malavon/kicad-ch341-programmer/todo.txt

SUSUMU: -T1 = 100 stuks; goedkoper full reel??? TODO

KOPEN: clips!!!
