malavon/kicad-ch341-programmer/3dmodels/TBC05-02-1-G-G.stp

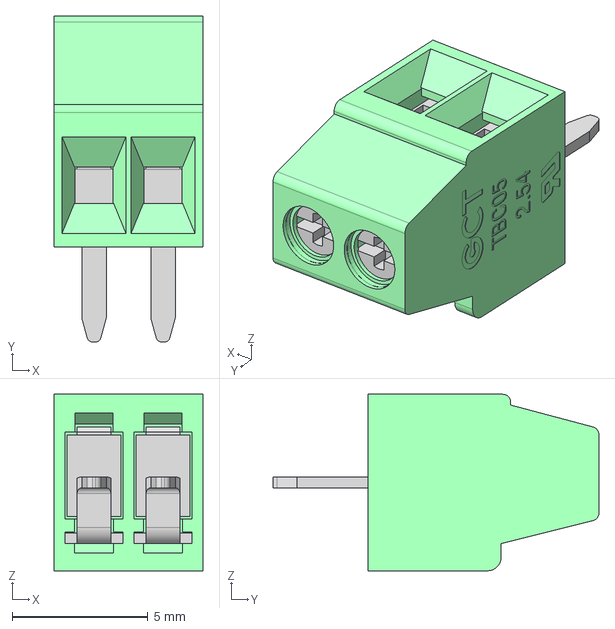
[picture p1: CAD file, 2026-05-10]
3dmodels/TBC05-02-1-G-G.stp
5.48 x 12.0 x 6.50 mm
TBC05-02-1-G-G_H
TBC05-02-1-G-G_P x 2
