malavon/kicad-ch341-programmer/3dmodels/amphenol_micro_usb_10118194-0011lf.step

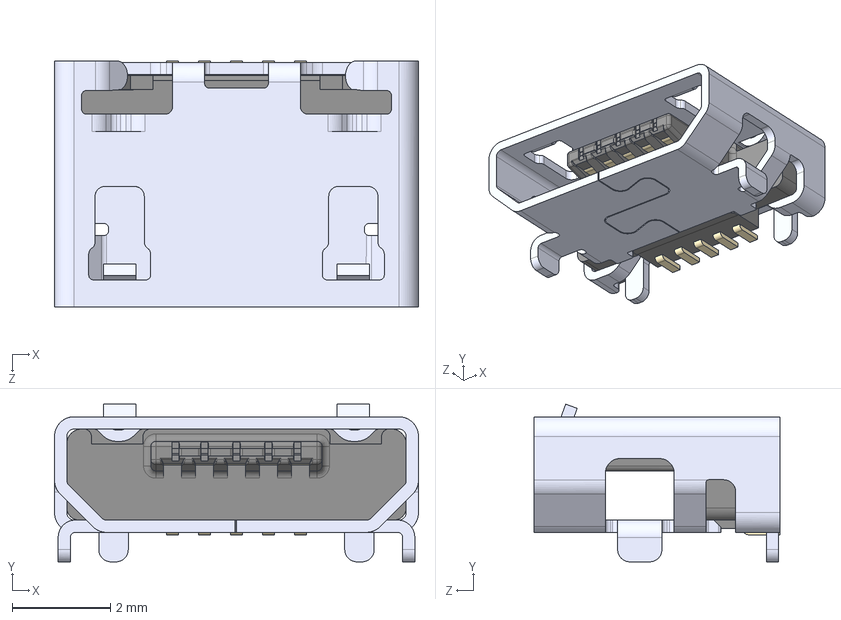
[picture p2: CAD file, 2026-05-10]
3dmodels/amphenol_micro_usb_10118194-0011lf.step
7.40 x 3.21 x 5.00 mm
