malavon/kicad-ch341-programmer/3dmodels/3m_zif_dip16_socket_216-3340-00-0602J_black.stp

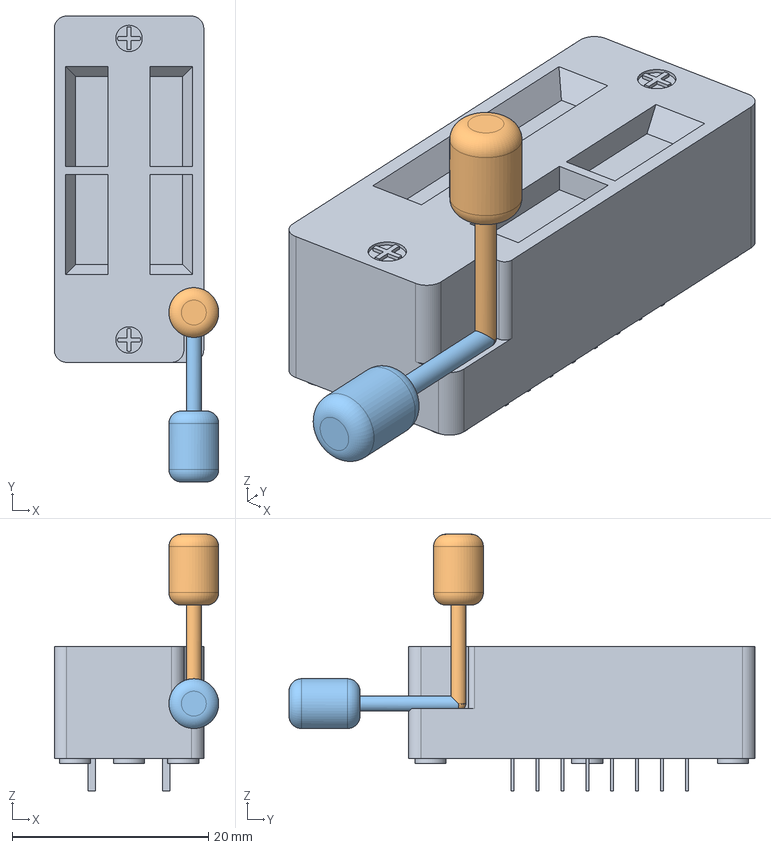
[picture p3: CAD file, 2026-05-10]
3dmodels/3m_zif_dip16_socket_216-3340-00-0602J_black.stp
16.8 x 47.5 x 26.2 mm
Compo-3
Compo-5
Compo-7
