malavon/kicad-ch341-programmer/3dmodels/c-282834-2-c-3d.stp

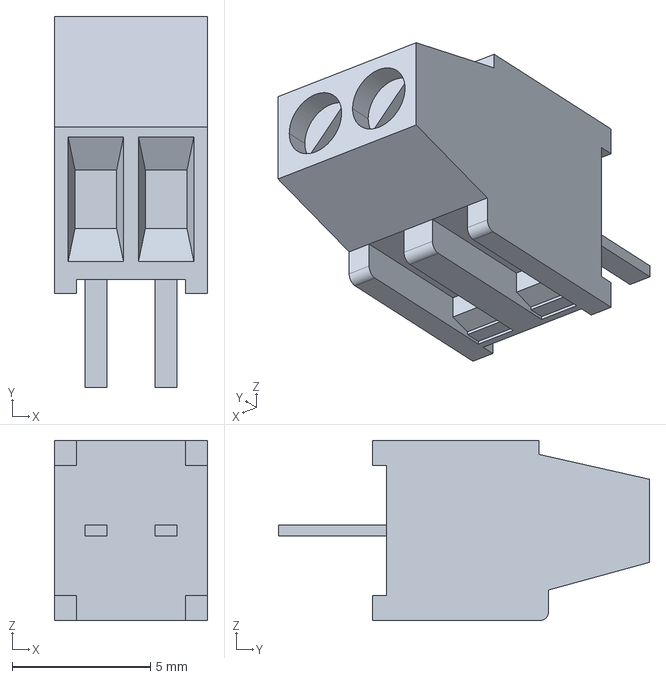
[picture p4: CAD file, 2026-05-10]
3dmodels/c-282834-2-c-3d.stp
5.54 x 13.4 x 6.50 mm
