malavon/kicad-ch341-programmer/3dmodels/397730002.stp

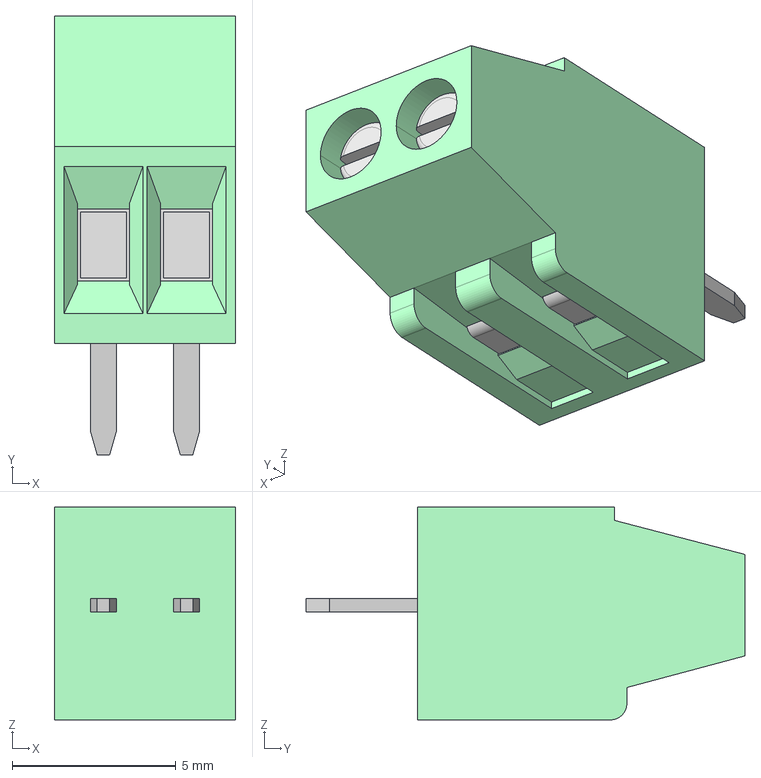
[picture p5: CAD file, 2026-05-10]
3dmodels/397730002.stp
5.54 x 13.4 x 6.50 mm
