malavon/kicad-ch341-programmer/(list of files, cad)

Other CAD files:
3dmodels/3m_zif_dip16_socket_216-3340-00-0602J_cyan.stp
3dmodels/3m_zif_dip16_socket_216-3340-00-0602J_parasolid.stp
