malavon/kicad-ch341-programmer/bios-programmer-ch341a.kicad_pcb

## KiCad design bios-programmer-ch341a.kicad_pcb (2026-05-10)

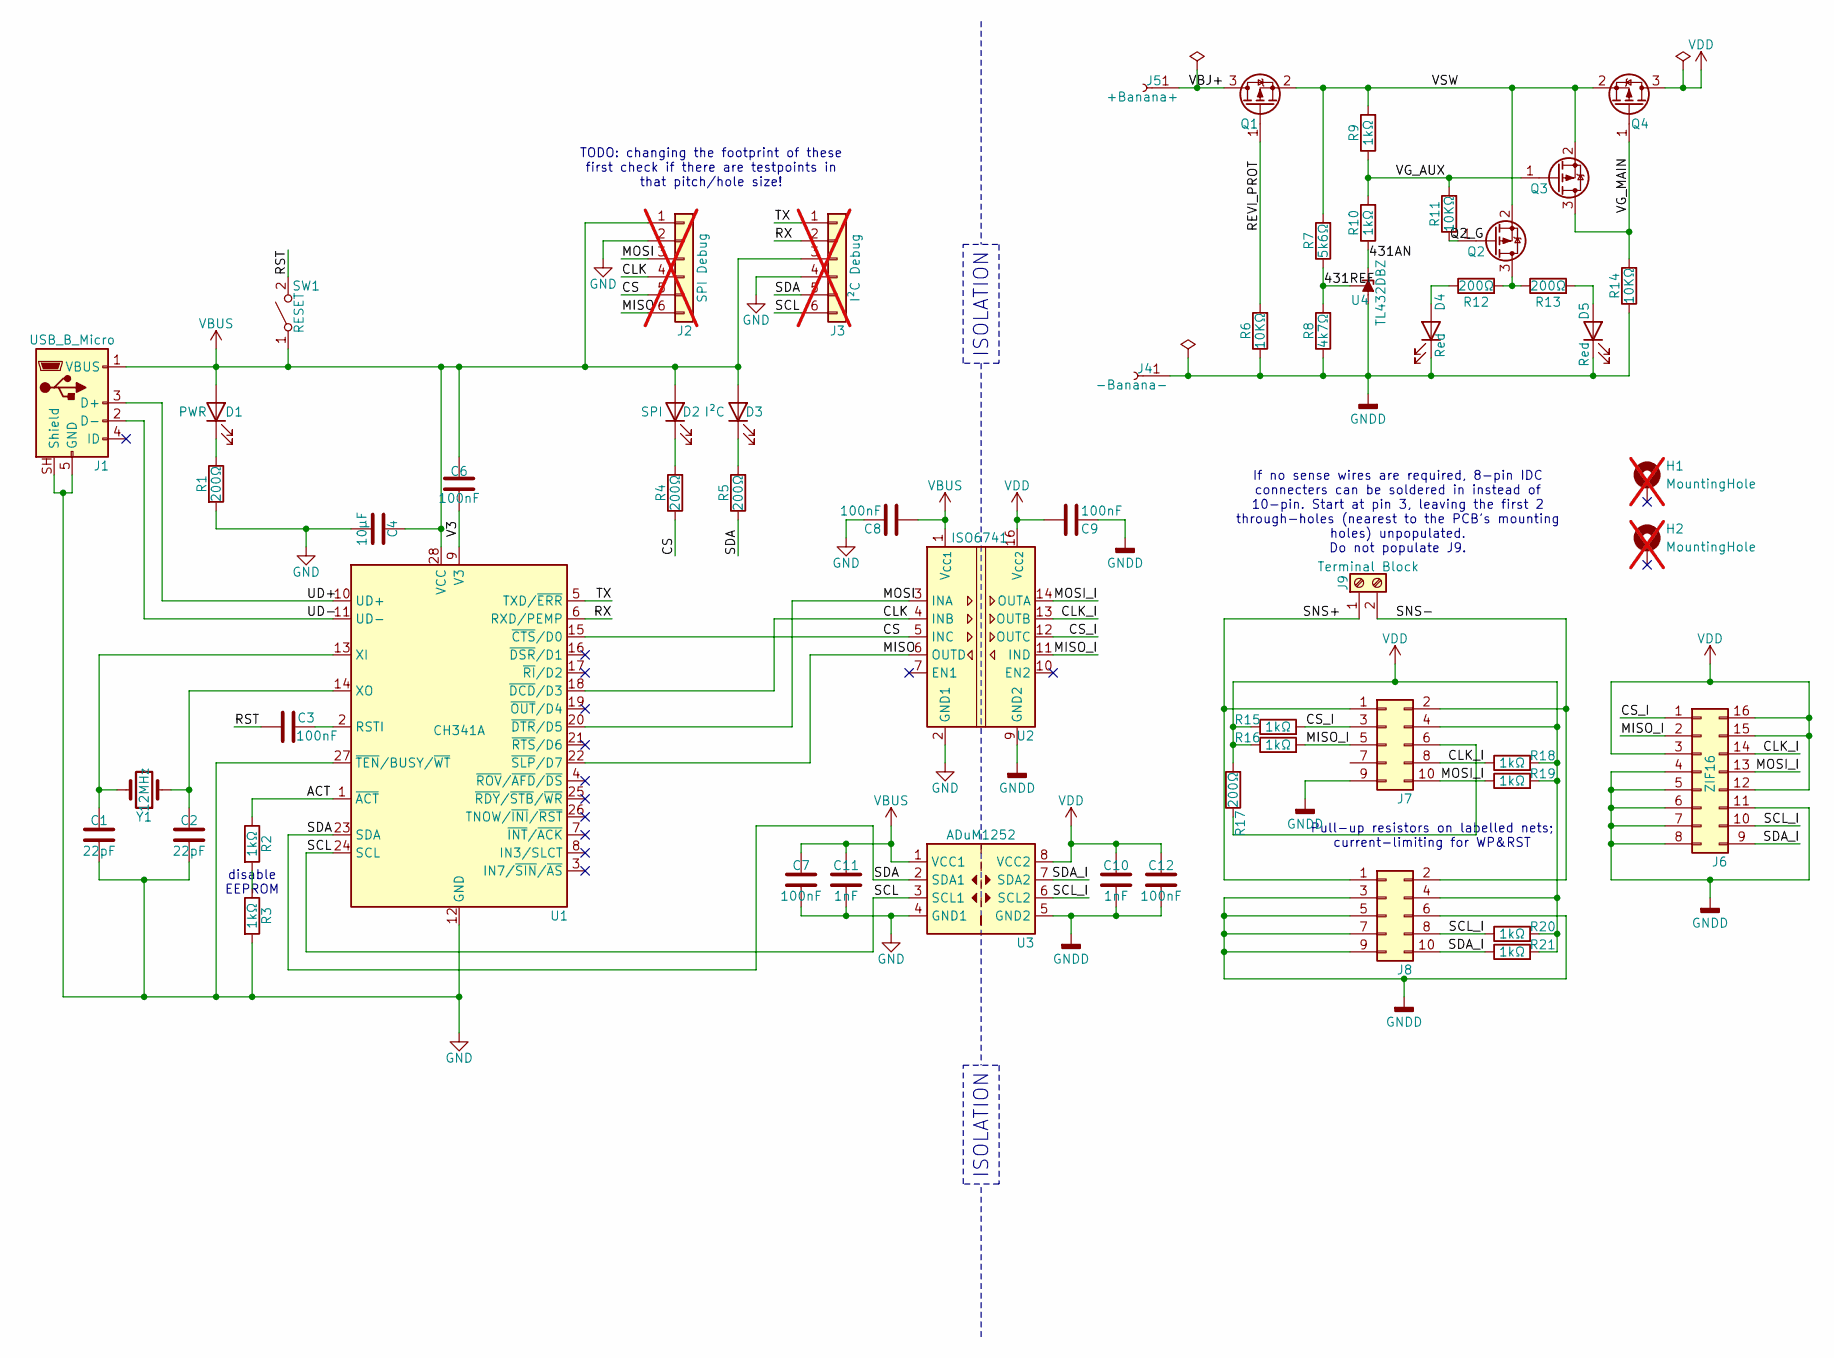
[picture p6: schematic bios-programmer-ch341a.kicad_sch]

Parts:
C1, C2: 22pF; C_0603_1608Metric_Pad1.08x0.95mm_HandSolder; Part KGM15ACG1H270GT
C3, C6, C7, C8, C9, C12: 100nF; C_0603_1608Metric_Pad1.08x0.95mm_HandSolder; Part CC0603KRX7R7BB104
C4: 10µF; C_0805_2012Metric; Part CL21A106KOQNNNF
C10, C11: 1nF; C_0603_1608Metric_Pad1.08x0.95mm_HandSolder; Part AC0603KRX7R0BB102
D1: Blue; LED_0603_1608Metric_Pad1.05x0.95mm_HandSolder; Part LTST-C194TBKT
D2, D3: YellowGreen; LED_0603_1608Metric_Pad1.05x0.95mm_HandSolder; Part HT-193UYG-5592
D4, D5: Red; LED_0805_2012Metric_Pad1.15x1.40mm_HandSolder; Part APT2012SURCK
H1, H2: MountingHole; MountingHole_2.2mm_M2_ISO14580_Pad_TopBottom; not fitted
J1: USB_B_Micro; USB_Micro-B_Amphenol_10118194-0001LF_Horizontal; Part 10118194(-0011LF)
J2: SPI Debug; PinSocket_1x06_P1.27mm_Vertical; not fitted
J3: I²C Debug; PinSocket_1x06_P1.27mm_Vertical; not fitted
J4: -Banana-; Banana_Cliff_FCR7350B_S16N-PC_Horizontal; Part FCR7350B
J5: +Banana+; Banana_Cliff_FCR7350R_S16N-PC_Horizontal; Part FCR7350R
J6: ZIF16; ZIF_Socket; Part 216-3340-00-0602J
J7, J8: IDC; IDC-Header_2x05_P2.54mm_Horizontal_1.64mm_pad; Part 61201021721
J9: Terminal Block; TerminalBlock_TE_282834-2_1x02_P2.54mm_Horizontal; Part TBC05-02-1-G-G
Q1, Q2, Q3, Q4: SSM3J328R; SOT-23; Part SSM3J328R
R1, R4, R5, R12, R13, R17: 200Ω; R_0603_1608Metric_Pad0.98x0.95mm_HandSolder; Part ERJ-3EKF2000V
R2, R3, R9, R10, R15, R16, R18, R19, R20, R21: 1kΩ; R_0603_1608Metric_Pad0.98x0.95mm_HandSolder; Part CQ03WAJ0102T5E
R6, R11, R14: 10KΩ; R_0603_1608Metric_Pad0.98x0.95mm_HandSolder; Part RC0603JR-0710KL
R7: 5k6Ω; R_0603_1608Metric_Pad0.98x0.95mm_HandSolder; Part RG1608P-562-D-T5
R8: 4k7Ω; R_0603_1608Metric_Pad0.98x0.95mm_HandSolder; Part RG1608P-472-D-T5
SW1: SPST; SW_Tactile_SPST_NO_Straight_CK_PTS636Sx25SMTRLFS; Part PTS636SKG25SMTR LFS
U1: CH341A; SOIC-28W_7.5x17.9mm_P1.27mm; Part CH341(A|B)
U2: ISO6741; SOIC-16W_7.5x10.3mm_P1.27mm; Part ISO6741DWR
U3: ADuM1252; SOIC-8_3.9x4.9mm_P1.27mm; Part ADUM1252ASA+
U4: TL432DBZ; SOT-23; Part TL432LIBCDBZ
Y1: 12MHz; Crystal_HC49-4H_Vertical; Part ABL-12.000MHZ-B2

Connections:
/431AN: R10.1, U4.2 (K)
/431REF: R7.1, R8.2, U4.1 (REF)
/ACT: R2.1, U1.1 (~ACT)
/CLK: J2.4, U1.18 (~DCD/D3), U2.4 (INB)
/CLK_I: J6.14, J7.8, R18.1, U2.13 (OUTB)
/CS: J2.5, R4.1, U1.15 (~CTS/D0), U2.5 (INC)
/CS_I: J6.1, J7.3, R15.2, U2.12 (OUTC)
/MISO: J2.6, U1.22 (~SLP/D7), U2.6 (OUTD)
/MISO_I: J6.2, J7.5, R16.2, U2.11 (IND)
/MOSI: J2.3, U1.20 (~DTR/D5), U2.3 (INA)
/MOSI_I: J6.13, J7.10, R19.1, U2.14 (OUTA)
/Q2_G: Q2.1 (G), R11.1
/REVI_PROT: Q1.1 (G), R6.2
/RST: C3.2, SW1.2 (B)
/RX: J3.2, U1.6 (RXD/PEMP)
/SCL: J3.6, U1.24 (SCL), U3.3 (SCL1)
/SCL_I: J6.10, J8.8, R20.1, U3.6 (SCL2)
/SDA: J3.5, R5.1, U1.23 (SDA), U3.2 (SDA1)
/SDA_I: J6.9, J8.10, R21.1, U3.7 (SDA2)
/SNS+: J7.1, J8.1, J9.1
/SNS-: J7.2, J8.2, J9.2
/TX: J3.1, U1.5 (TXD/~ERR)
/UD+: J1.3 (D+), U1.10 (UD+)
/UD-: J1.2 (D-), U1.11 (UD-)
/V3: C6.2, U1.9 (V3)
/VBJ+: J5.1 (Pin_1_1), Q1.3 (D)
/VG_AUX: Q3.1 (G), R9.1, R10.2, R11.2
/VG_MAIN: Q3.3 (D), Q4.1 (G), R14.2
/VSW: Q1.2 (S), Q2.2 (S), Q3.2 (S), Q4.2 (S), R7.2, R9.2
GND: C1.2, C2.2, C4.2, C7.2, C8.2, C11.2, J1.5 (GND), J1.SH (Shield), J2.2, J3.4, R1.2, R3.2, U1.12 (GND), U1.27 (~TEN/BUSY/~WT), U2.2 (GND1), U2.8 (GND1), U3.4 (GND1)
GNDD: C9.1, C10.2, C12.2, D4.1 (K), D5.1 (K), J4.1 (Pin_1_1), J6.4, J6.5, J6.6, J6.7, J6.8, J6.11, J7.9, J8.3, J8.5, J8.6, J8.7, J8.9, R6.1, R8.1, R14.1, U2.9 (GND2), U2.15 (GND2), U3.5 (GND2), U4.3 (A)
unnamed: D1.1 (K), R1.1
unnamed: D2.1 (K), R4.2
unnamed: D3.1 (K), R5.2
unnamed: D4.2 (A), R12.1
unnamed: D5.2 (A), R13.2
unnamed: Q2.3 (D), R12.2, R13.1
unnamed: R2.2, R3.1
unnamed: C3.1, U1.2 (RSTI)
unnamed: C1.1, U1.13 (XI), Y1.2
unnamed: C2.1, U1.14 (XO), Y1.1
VBUS: C4.1, C6.1, C7.1, C8.1, C11.1, D1.2 (A), D2.2 (A), D3.2 (A), J1.1 (VBUS), J2.1, J3.3, SW1.1 (A), U1.28 (VCC), U2.1 (V_{CC1}), U3.1 (VCC1)
VDD: C9.2, C10.1, C12.1, J6.3, J6.12, J6.15, J6.16, J7.4, J8.4, Q4.3 (D), R15.1, R16.1, R17.2, R18.2, R19.2, R20.2, R21.2, U2.16 (V_{CC2}), U3.8 (VCC2)

Notes on the sheet:
disable EEPROM
TODO: changing the footprint of these first check if there are testpoints in that pitch/hole size!
If no sense wires are required, 8-pin IDC connecters can be soldered in instead of 10-pin. Start at pin 3, leaving the first 2 through-holes (nearest to the PCB's mounting holes) unpopulated. Do not populate J9.
ISOLATION
Pull-up resistors on labelled nets; current-limiting for WP&RST

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
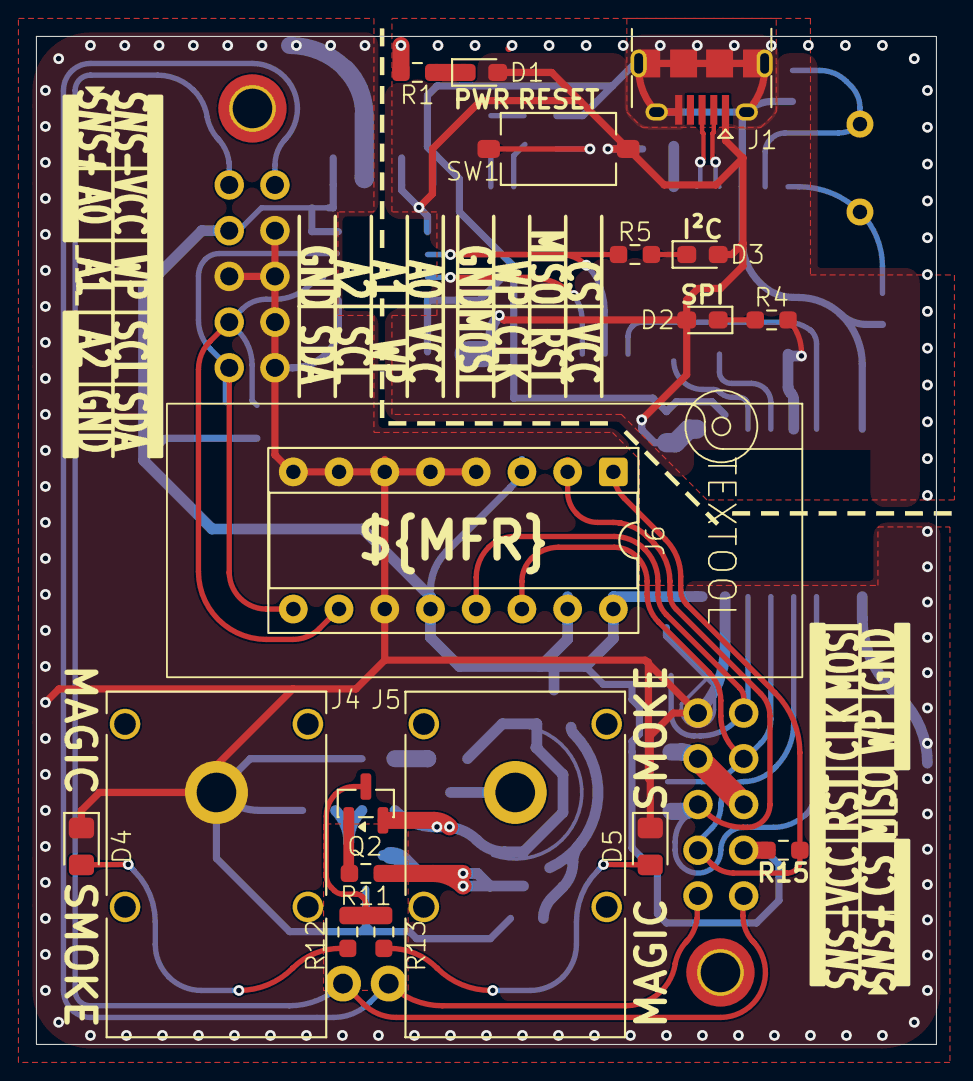
[picture p7: board bios-programmer-ch341a.kicad_pcb from above]

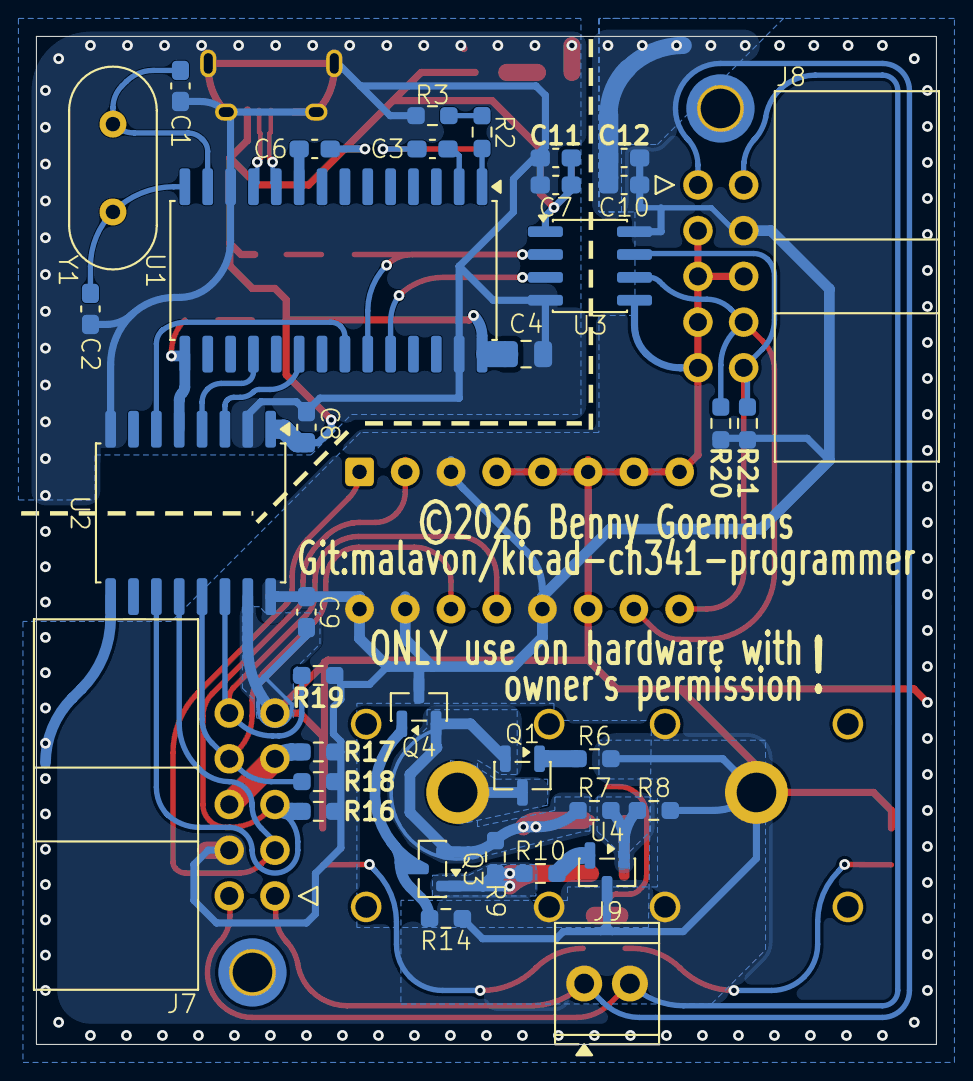
[picture p8: board bios-programmer-ch341a.kicad_pcb from below]

Board: 2 copper layers, 50.0 x 56.0 mm, 56 parts (36 on the bottom side), 42 nets.
