malavon/kicad-ch341-programmer/(commit log)

2026-05-05 SCH: off-the-shelf CH341a programmer
    Typical CH341a programmer, based on a schematic I found on or via EEVBlog.
    It groups all capacitors at the moment, but that's fine. Capacitances will need
    to change anyway. I didn't use a resistor network like the programmer does, but
    nothing stops me from changing this later on.
    [bios-programmer-ch341a.kicad_pcb, bios-programmer-ch341a.kicad_sch]
2026-05-05 SCH: initial isolated version
    It's more than likely that the isolation pinout will change for easier routing.
    All DRC rules are passed EXCEPT one: SCL connection complains that it's not
    connected to power on the ZIF socket. Either this is a DRC mishap, or something
    is actually wrong with the idea or the isolator used.
    Note: isolator part numbers are expected to change, hopefully pinout doesn't.
    It's possibly I decide to use a 4 or 6-channel isolator instead of 3 dual ones.
    [bios-programmer-ch341a.kicad_sch]
2026-05-05 Temporary footprint assignations.
    Missing:
    * ZIF socket
    * correct 3.3V regulator (schematics)
    * BANANA JACKS!!
    * correct USB plug; vertical? horizontal? sideways like laptop...
    * no inductor??? (original schems)
    [bios-programmer-ch341a.kicad_pcb, bios-programmer-ch341a.kicad_sch]
2026-05-05 Correct isolator types
    Initially I was hoping to re-use isolation for both the I2C & SPI memory types.
    In short, I require 1.8V operation on at least one side. This is already hard
    to find in I2C regulators (e.g. TI does only 2.25V parts).
    However, the I2C parts are considerably more expensive, so reusing those would
    more than double the price (in total). On top of that, they only support speeds
    up to 2MHz.
    On the SPI side there are a few options, most notably TI's ISO65xxx range. It's
    the cheapest option, but only comes in a smaller package than I'd really like
    for handsoldering. Therefore I went with the slightly older ISO67xxx option.
    This is the same package width/pitch as the CH341a it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
    [bios-programmer-ch341a.kicad_pcb, bios-programmer-ch341a.kicad_sch]
2026-05-05 Added the 3M TEXTOOL 16-pin ZIF socket footprint & 3D model
    Note: the CH341a programmers usually use a TFXTDOL (sic...) ZIF socket.
    Surely it won't be the same quality but I guess it gets the job done for a
    fraction of the price (a programmer is sold at 0.80 Euro, the ZIF socket is
    sold for 22...).
    The 3D model for the ZIF socket makes it clear how big it is. This is also
    evident on other programmers using one of these, but it's good to have it to
    check for clearances.
    [bios-programmer-ch341a.kicad_pcb, bios-programmer-ch341a.kicad_sch]
2026-05-05 Banana Jack footprints
    At first I couldn't find any banana jack footprints, but I guess they're there
    nonetheless. The one I chose has the same footprint but is from a different
    manufacturer, Schuetzinger.
    And now I don't need to provide the 3d model either. Win!
    [bios-programmer-ch341a.kicad_pcb, bios-programmer-ch341a.kicad_sch]
2026-05-05 Changed USB A to Micro USB
    First question: why not USB-C? Simple, because I have many more Micro USB
    cables lying about. Also, I have a few issues with how USB-C was both designed
    and came to fruition. That said, it should be trivial to redesign a USB-C port
    on the PCB (and I may do this in the future).
    [bios-programmer-ch341a.kicad_pcb, bios-programmer-ch341a.kicad_sch]
2026-05-05 3D: model for Amphenol Micro USB, PN 10118193-0002LF (2=without flange)
    Apparently this model requires a very big lateral movement, but I guess it'll
    be fine.
    [amphenol_micro_usb_11018193_2lf.stp, bios-programmer-ch341a.kicad_pcb]
2026-05-05 Notes after reading the CH341 datasheet & crystal package
    The todo list has been expanded with both additions and simplifications. I'll
    be running the CH341 on 5V since it never connects directly to any chip.
    It would also be perfectly fine to provide less capacitance if there's no real
    load on the device, especially no chance of a surge current on the USB bus.
    All programming load will be monitored by the external connection anyway.
    [bios-programmer-ch341a.kicad_pcb, bios-programmer-ch341a.kicad_sch]
2026-05-05 Removed voltage regulator, running from VBUS directly + dual status LEDs
    I left the debug headers intact for now but that's next up.
    Having dual LEDs as status LED is rather useful, I could have these next to the
    ZIF socket to notify the user which one is getting used. It might prevent some
    user errors.
    Note: future (alternatives) will probably not use a ZIF socket but connect to a
    clip through a ribbon wire. OR I may decide to put it all on a single PCB.
    [bios-programmer-ch341a.kicad_pcb, bios-programmer-ch341a.kicad_sch]
2026-05-05 Cleanup of tracks and condensing a bit + adding the Ohm symbols again
    I cannot resist using correct units.
    The layout as it is doesn't cross any signals, at the cost of becoming slightly
    more difficult to follow. Then again, it's a simple design and supposed to stay
    that way.
    [bios-programmer-ch341a.kicad_pcb, bios-programmer-ch341a.kicad_sch]
2026-05-05 Added a reset switch and removed RST & ACT signals from debug headers
    The reset is probably useful, I've had plenty of times that one of these CH341
    chips or the chip under programming stopped responding because something went
    wrong with the software.
    No need to unplug the USB all the time, reset switches should be more omni-
    present.
    Those 2 extra signals aren't really needed for debugging if there's a switch,
    ACT was barely useful anyway. Also note that these parts are DNP anyway.
    And I might turn it into 2mm or even 1mm pitches if need be. I should check up
    on test point (those clip-on ones) sizes before I do so though.
    [bios-programmer-ch341a.kicad_pcb, bios-programmer-ch341a.kicad_sch]
2026-05-05 Isolators input (VCC) capacitance
    Added the required input capacitance on both isolators as specified in the
    datasheet.
    [bios-programmer-ch341a.kicad_pcb, bios-programmer-ch341a.kicad_sch]
2026-05-05 PCB: IDC connector on the bottom, also functioning as standoffs
    The idea is that a chip can be programmed through the ZIF socket or by connect-
    ing a cable with a in-place programming clip.
    This may however lead to issues and in hindsight it might become a questionable
    decision: the high-speed signals will be branched and lead nowhere, which may
    lead to reflections and thus signal integrity failure.
    The cheap CH341 programmers do not use separate IDC connectors but instead
    use the ZIF socket and a IDC adapter. This does prevent possible signal
    integrity issues at the cost of an ugly adapter which doesn't prevent mis-
    alignment.
    If I choose to go this route myself I will have to create a be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
    [bios-programmer-ch341a.kicad_pcb, bios-programmer-ch341a.kicad_sch]
2026-05-05 First layout test & opt for 2 IPC connectors instead of 4
    This layout is very preliminary and I'm committing this because I want to try
    out a different layout.
    Using 2 IPC connectors is probably best:
    * still provides support when used diagonally - at least I expect them to
    * no branching of signals, just one long string crossing THROUGH the ZIF socket
    Note that I'm having some troubles with the USB connection, D+ & D- are in the
    wrong way to link directly to the CH341a when used on the same side.
    So either I need to find a Micro USB B with through hole signal connections,
    or I need to cross them by using an extra pair of vias.
    [bios-programmer-ch341a.kicad_pcb, bios-programmer-ch341a.kicad_sch]
2026-05-10 PCB: redesign, reducing footprint & optimizing layout
    IMPORTANT: I've switched up the footprint of the ZIF socket (will require
    doublechecking) in order to improve the routing.
    All in all I'm pretty content with this layout idea, routing goes well and most
    of the important parts have been routed in this example.
    However, due to the orientation of the CH341 it will be difficult to route the
    USB data signals. Since these are high-speed - the highest of all signals on
    this board - it is imperative that these are routed better. On top of that it's
    good to route these within a grounded channel.
    Then the test headers...they have been giving me trouble. In fact that's the
    reason I rotated the CH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
    [bios-programmer-ch341a.kicad_pcb, bios-programmer-ch341a.kicad_sch]
2026-05-10 PCB: reset button & ACT pulldown
    Pulling down ACT (throught a resistor) disables the CH341 EEPROM check to find
    its configuration. Only programmatic configuration is supported in order to
    switch from SPI to I2C and vice versa.
    PROBLEM: while checking the PCB I noticed that the ZIF socket - for which I've
    changed the signal order - isn't correct. Or technically it is, it's just
    upside down. However, it would be nicer to have pin 1 of the zif socket be
    pin 1 of the (first of two) memory chips.
    Changing this will change a lot of the signals coming from the isolators and
    going towards the IDC connectors.
    [bios-programmer-ch341a.kicad_pcb, bios-programmer-ch341a.kicad_sch]
2026-05-10 PCB: Fixed the ZIF socket layout, pin 1 is pin 1 on SPI (NOT EEPROM)
    I still keep the 25/24 order simply because the layout gets much worse if I
    change these up. There will be a very clear silkscreen explaining which chip
    goes in which part of the socket (including the pinout).
    PROBLEM: I did notice that one the left side of the PCB there's GND and GNDD
    overlapping each other. Unless I can fix this easily another way, I can only
    see one possible fix: place U3 (I2C isolator) in-between the J8 (IDC connector)
    and U1 (the CH341 IC).
    Most likely this will mean there is no more room to place the debug headers,
    permanently or temporarily.
    [bios-programmer-ch341a.kicad_pcb, bios-programmer-ch341a.kicad_sch]
2026-05-10 PCB: Isolation of I2C signals without overlapping ground connections
    As expected this solution seems to make it impossible to have the debug headers.
    Unless I can find a way they won't be there in the final version.
    [bios-programmer-ch341a.kicad_pcb, bios-programmer-ch341a.kicad_sch]
2026-05-10 Footprint: Micro USB (Amphenol 10118194) footprint & 3d model
    Right part number: 10118194-0011LF
    4 DIP part, best structual support I could find. 11 stands for "without flange"
    and "76um au"
2026-05-10 PCB: updated Micro USB B model to Amphenol 10118194-0011LF + IC capacitance
    [bios-programmer-ch341a.kicad_pcb, bios-programmer-ch341a.kicad_sch]
2026-05-10 Idea on a possible overvoltage protection circuit that might work - or not
    Copy from the schematics:
    * zener diode 5.6V
    * switches off a P-mosfet on the banana rail
    * but what about a LED
    * cannot just put a LED in series, right?
    * calculate!! Vfz=0.9V, Vfled=2.0V
    * it's fine, isn't it??
    combined forward voltage well below the 5.6V
    * can the MOSFET still switch when 3.6V is applied?
    * gate voltage needs to be higher than what is switched?
    [bios-programmer-ch341a.kicad_sch]
2026-05-10 PCB: placing capacitors, crystal & LEDs + reference designators placed
    LEDs are on top since that's obviously where the user will see them. Still no
    debug headers present, I don't think I'll be putting them in.
    The crystal is changed into the same crystal that I can find on the CH341
    programmer PCB. I'm not sure they're easy to recover and safe to reuse.
    Nonetheless I'm consdering buying CH341 programmers and recovering the chips &
    ZIF sockets. The cost difference is quite big (especially for the sockets).
    Tracks certainly still need to be cleaned up, zones laid out etc. Still some
    rework as well, but it's good enough to have an idea and maybe post it out on
    an electronics forum. Let's hop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
    [bios-programmer-ch341a.kicad_pcb, bios-programmer-ch341a.kicad_sch]
2026-05-10 PCB: intermediate commit with fixes & changing solder mask color for each layer
    First things first, of course I have no intention of ordering this PCB ever
    with two different solder mask colors. It's simply to make it easier for me to
    see what's happening. Since I use the 3D viewer a lot to inspect zones in a
    much cleaner perspective than in the PCB editor, having two different colors
    makes it easier to distinguish them both. Especially without models populated
    they look not that much different from each other, I've had a few moments I had
    to doublecheck which side I'm one.
    Some tracks have been rerouted to allow for bigger zones where possible.
    Isolated GND is on top, isolated voltage on t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
    [bios-programmer-ch341a.kicad_pcb]
2026-05-10 PCB: isolated GND on top and isolated power at the bottom
    The other way around results in messier routing and the PCB is big enough to
    have a few tracks around to provide power, which are then usurped into zones.
    Note that I have a habit - for the 4 pcb's I've more or less designed - of
    connecting all pins before going into zones. Zones might be a useful tool to
    see if routing is possible, but I prefer it this way because it makes me think
    more about the layout and its consequences.
    VBUS & GND are not yet done, at this stage I'm still trying to figure out which
    net to put on which side of the board.
    [bios-programmer-ch341a.kicad_pcb]
2026-05-10 PCB: routed VBUS at the bottom, GND on top
    I tried it the other way around with VBUS on top and GND on the bottom side,
    but this resulted in pretty annoying jumps & vias. This one is cleaner, there's
    only one overjump to be made.
    [bios-programmer-ch341a.kicad_pcb, bios-programmer-ch341a.kicad_sch]
2026-05-10 PCB: moved ISO6741 more inwards
    Originally pins for the socket came out much further since it was oriented
    differently and - I think - I kept it this far to the side just by coincidence.
    [bios-programmer-ch341a.kicad_pcb, bios-programmer-ch341a.kicad_sch]
2026-05-10 PCB: ring of fire; grounded vias around the pcb to improve signal integrity.
    This is something I saw on the black version of the CH341 programmer and I
    wanted to try out laying this out as well.
    The green versions that I have - which have a voltage selection switch - do not
    have such a ring and they work perfectly fine (with the limitations of these
    simple devices). Not sure if it's useful at all thus, but I'm going to assume
    that it doesn't harm anything. Let's hope these aren't going to be famous last
    words.
    Having added this it's clear that there is quite a bit of extra surface area
    that hasn't been used nor has any use. So if I decide to remove this ring at a
    later stage, I might just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
    [bios-programmer-ch341a.kicad_pcb, bios-programmer-ch341a.kicad_sch]
2026-05-10 PCB: components moved inside Ring of Fire + fixed grouping & locking
    While I will never know if this ring around the PCB has any merit, it does mean
    that some of the components had to move a bit. No issues created as far as I
    can see.
    The grouping that I had done was apparently messed up, so I've had to redo this
    by moving them to the side and finally grouping, moving back & locking them.
    Note sure if it was messed up because of a bug or by design - or something I
    did wrong.
    [bios-programmer-ch341a.kicad_pcb, bios-programmer-ch341a.kicad_sch]
2026-05-10 PCB/footprints: Replaced reset switch with a smaller (and cheaper) model
    C&K PTS636 is also already in Kicad, it's affordable and should be more than
    enough for this simple board.
    More notably it's rectangular and takes up less space than the big one I had
    before. I do like that one better, but it's a bit big for this board.
    Now it'll also be possible to have it all on the - unofficially - isolated side
    of the pcb.
    [bios-programmer-ch341a.kicad_pcb, bios-programmer-ch341a.kicad_sch]
2026-05-10 PCB: so satisfying ... rounded some tracks just because I can :)
    Yeah, I shouldn't ben doing this since it's strictly not necessary. But just
    imagine all these electronics moving at light speed and then bumping again a
    sharp corner! They might hurt themselves, possibly leading to a universe-ending
    event. Or not.
    Technically I'm pretty sure I read a application note or something about it
    once, but I'm also pretty sure that all of this has happened before at least
    once. So yeah, fun life, right?
    [bios-programmer-ch341a.kicad_pcb]
2026-05-10 PCB: added silkscreens for pin layout and found BIG ISSUE
    These silkscreens are quite important simply to understand what the device does
    and prevent mistakes. They need to be correct and placed in a way they can be
    read easily without mistakes.
    As I expected I seem to have made a mistake on at least the pinouts of the IDC
    connectors. That's too bad since I'l have to reroute them after correcting this.
    First things first however, I'm going to verify the pinout of both the IDC con-
    nectors and the ZIF socket with every reference I have.
    The worst thing that could happen - as it's hard to fix with an extra compoent
    or a hookup wire - is a mistake in the pinouts. All of the PCBs that I order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
    [bios-programmer-ch341a.kicad_pcb, bios-programmer-ch341a.kicad_sch]
2026-05-10 SCH/PCB: corrected external pinouts - hopefully correct now
    First part that was wrong was the footprint vs symbol which didn't have a
    compatible pin numbering. Then aside from that there were still mistakes that
    lead to wrong pinouts.
    By rerouting the SPI signals it seems easiest to route them under the ZIF
    socket, which I've been able to prevent previous time. Not that that's much of
    an issue as far as I can estimate.
    The silkscreen legend for the ZIF socket was also wrong, somehow I still have
    the layout from the off-the-shelf programmers (with 24xx on top) in my mind.
    This is definitely one of the downsides of changing this, but also show the
    importance of having good silkscreen legends.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
    [bios-programmer-ch341a.kicad_pcb, bios-programmer-ch341a.kicad_sch]
2026-05-10 SCH: overvoltage (concept)
    [bios-programmer-ch341a.kicad_sch]
2026-05-10 PCB: cleaned up DRC errors & moved silkscreens/vias neater
    Not that it matters much because while doing this I noticed it might be better
    to move a few IC's, including the CH341. This will mean all tracks are moved as
    well, breaking a lot of things.
    Definitely one of the things Kicad doesn't exactly excel at.
    prolly temp: cleaned up DRC errors, moved silkscreens/vias where need be
    but going to move a few IC's ... breaking all tracks and creating more errors
    [bios-programmer-ch341a.kicad_pcb]
2026-05-10 PCB: moved U1 (CH341) closer to J8/U3 (I2C isolator) and more beautification
    Moving U1 is useful to make extra room for the crystal - even if I decide to
    choose a different footprint. It's one of the most sensitive components.
    Of course moving this meant that all tracks and thus vias on the USB/host-side
    also needed moving. I decided to use this opportunity to give components some
    extra room where possible. While I'm certain I can handsolder this, simply for
    interference reasons it might be worth it.
    I also moved all vias that clipped silkscreen now. I had done this before but
    of course changes to the slikscreen and its placement meant the vias would clip
    it. Anywhere it's relevant - visib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
    [bios-programmer-ch341a.kicad_pcb, bios-programmer-ch341a.kicad_sch]
2026-05-10 3D: model of the ZIF socket
    This model is embedded in the footprint that I made, which I prefer. But it's
    good to keep the model in the repo as well, just to be complete.
    Note that this was originally a parasolid .x_t file, which I managed to convert
    using an online converter. Apparently no open-source solutions exist?
    [3m_zif_dip16_socket_216-3340-00-0602J_parasolid.stp]
2026-05-10 Kicad jobsets to generate outputs/exports; no real success though
    It seems that not everything that is possible with the CLI is also possible
    from the jobsets. On top of that I also wasn't able to zip the gerbers using a
    separate command. Note that documentation I saw would mention an 'archive' task
    but I haven't found this one.
    [bios-programmer-ch341a.kicad_pcb, bios-programmer-ch341a.kicad_sch]
2026-05-10 EXPORT: exporting using script & kicad-cli
    The CLI has more options than the jobsets do, or at least the jobsets' UI has.
    It's not the most efficient option since it has to re-read the project each for
    each export.
2026-05-10 PCB: moved to the exact center of the page for cleaner export results
    It's more or less unnecessary, but it does make it easier to print out the PCB
    doublesided (assuming it's correctly rotated or mirrored).
    [bios-programmer-ch341a.kicad_pcb]
2026-05-10 SCH: Initial version of overvoltage protection
    While trying to get a grasp of this design which was proposed by ChatGPT very
    confidently I started to delve into simulating.
    I decided to keep this commit but DO KNOW that this circuit doesn't work. It's
    just here to remind me to simulate before even putting things into a schematic.
    And of course not trust LLMs to generate something even reasonably close, just
    like I have witnessed these things do with code.
    [bios-programmer-ch341a.kicad_sch]
2026-05-10 SIM: QUCS-S simulations for overcurrent protection
    I've included several versions of an overvoltage protection circuit I found on
    Stack Exchange. I arrived there after trying to have ChatGPT create a circuit
    or at least help me in doing so. It was very good at being confidently useless,
    especially when I started simulating its creations. It's also rather funny to
    see it confuse P- and N-channel symbols and other stuff.
    That said, it's not completely useless, but there needs to be a good way to
    verify options before believing its output. This is by far my experience with
    trying to have it generate working code. It's very good at bullshitting when
    something doesn't work and going on an endles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
    [basedonstackex.sch, stackexchange1.sch, stackexchange2.sch]
2026-05-10 SIM: models for a few zener diodes and P-channel MOSFETs
2026-05-10 SIM: changing components to to library ones, output voltage goes above 6V
    Using library components ensures that there are no mistakes in the models.
    In this case ChatGPT was actually useful in noticing errors, although QUCS-S
    does seem to use 'M' for 'milli' instead of 'mega' as it should? Odd.
    Using these models the output voltage is allowed to go over 6V, which is rather
    high. This could be alleviated using a 5.1V Zener diode presumably.
    [basedonstackex.sch, stackexchange2.sch]
2026-05-10 SIM: simulation using a TI TL431 shunt diode
    ChatGPT mentioned this as a better solution to the Zener design, most likely
    helped by ingesting sites like Stack Exchange & reddit...
    Anyway, on the previously mentioned SE thread there's also a TL431 option, so
    I decided to try that one instead of going through trial and (a lot of) error
    using LLMs.
    [basedonstackextl341.sch]
2026-05-10 SIM: added diode to remove undershoot when sweeping load resistance
    Recommended by ChatGPT of course, not on the SE design. In fact, the SE design
    has a resistor feeding back into the TL431's reference. I tried this too, but
    the design didn't get cleaner at all. It actually got worse so it's starting to
    feel like a tuning problem, something I'd rather not have. I prefer a circuit
    that isn't too unstable, depending on other components.
    [basedonstackextl341.sch]
2026-05-10 SIM: added temperature option to simulate temperature effects
    I'm sure I can sweep this somehow, I think I saw it in the QUCS-S tutorial pdf.
    [basedonstackextl341.sch]
2026-05-10 SIM: includes LED indicated & removed capacitor
    The simulation seems to be quite good, although there are still some issues at
    low loads. The output voltage seems too low in those cases, which shouldn't
    really happen.
    [basedonstackextl341.sch]
2026-05-10 SCH: moving the simulated power protection circuit into Kicad
    [bios-programmer-ch341a.kicad_sch]
2026-05-10 SCH: added mounting holes & footprints assigned for PCB
    Mounting holes aren't strictly necessary and could in fact create some sort of
    coupled effects into the (isolated) ground plane. Especially when putting this
    in a metal case and connecting the USB ground to the case (hard to avoid) I
    don't know what the effects would be. That said, mounting holes are useful.
    [bios-programmer-ch341a.kicad_sch]
2026-05-10 PCB: power protection path laying out components
    [bios-programmer-ch341a.kicad_pcb]
2026-05-10 SIM: using Zener diode & schottky on output
    The Zener diode is used in the stack exchange post as a simple solution to
    create a voltage cut-off. The Schottky diode on the output is a stop-gap
    measure proposed by ChatGPT to reduce some ringing. I do not like this solution
    much though.
    [basedonstackex.sch]
2026-05-10 SIM: TL431 resistor changes & led current increase
    Brighter (error) LEDs are fine, but at higher voltages this will overdrive them
    and thus destroy them. It shouldn't really happen though, the operating point
    for this design is between 1.8 and 5V. Overvoltage should be 5.5-6V, not 8V or
    much higher.
    [basedonstackextl341.sch]
2026-05-10 SCH: updated protection circuit in line with simulation changes
    Replaced the 5.6K resistor with a second 4.7K combined with a 1K one. It saves
    one type of resistor to be ordered.
    220 ohm resistor on LED.
    [bios-programmer-ch341a.kicad_sch]
2026-05-10 PCB: swapped banana pos & neg! Using TL432 alternate for overvoltage circuit
    Ok, first and foremost the swapping of positive and negative banana jacks.
    Doing this at this stage isn't incredibly easy, but it had to be done. Because
    the board (in Kicad) is essentially upside down, the banana jacks are in the
    opposite order of most bench DC psus.
    Changing this of course has its repercussions on the layout of the overvoltage
    circuit, but I did manage to keep everything on the bottom layer except for the
    LED circuit. It's perfectly fine for that to be on a different layer. I really
    wanted to prevent the TL431/TL432's signal to be routed through vias which
    could possible influence the resistance.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
    [bios-programmer-ch341a.kicad_pcb, bios-programmer-ch341a.kicad_sch]
2026-05-10 SIM: using different P-MOSFETs: Toshiba SSM3J328R
    Reasonably cheap in the category of 1.8 or lower voltage at which RDS(on) is
    specified. The previous IRLML6402 only had specifications for 2.5V, which is
    much higher than what I need to support with 1.8V. Also, that part seems to be
    in last-chance order status.
    I would have used the Diode Inc DMP2305U, but the SPICE model is less detailed
    and this makes the simulation less useful. Let's use a part that I can more or
    less guarantee to work well. If I can find a better model I might rethink this,
    though the price difference isn't big anyway. Most likely it'd work anyway.
    [basedonstackextl341.sch]
2026-05-10 SIM: no longer need the diode on the output to cleanup gate undershoot
    This diode was advised to me by ChatGPT, a tool that has turned out to be both
    very unhelpful and a few times helpful. While it did correct the effect where a
    negative voltage occurred on the gate of the switching MOSFET, it shouldn't be
    there. I have no control on whatever is on the output side, it should just be
    as clean as possible without "help" from a diode.
    After finding out that the MOSFETs I had weren't really great for this design,
    something that ChatGPT did not notice while it was sure to notice every effect
    from every parameter out there. The amount of times I had issues because one
    of the models wasn't good e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
    [basedonstackextl341.sch]
2026-05-10 PCB: power path protection reasonable layout TODO
    probably final version including power-path protection TODO explain some more? first check previous commit, rebase etc
    different mosfet! Toshiba thingy
    zones for almost everything
    wider tracks
    and yeah, accidental symbol ...
    [bios-programmer-ch341a.kicad_pcb, bios-programmer-ch341a.kicad_sch]
2026-05-10 SIM: sweeping load lower than 20 Ohm results in faster cut-offs TODO: realistic?
    has something to do with the current; but 0.5A current should be well possible at 1.8V...
    [basedonstackextl341.sch]
2026-05-10 diode removed, zones improved, temp commit?
    [bios-programmer-ch341a.kicad_pcb, bios-programmer-ch341a.kicad_sch]
2026-05-10 pcb temp almost done; the only thing I don't like is the GND bridge
    [bios-programmer-ch341a.kicad_pcb]
2026-05-10 pcb: arc zone turned to tracks
    [bios-programmer-ch341a.kicad_pcb]
2026-05-10 PCB: moved OVP LED tracks down, added LED resistor and some beautification
    [bios-programmer-ch341a.kicad_pcb, bios-programmer-ch341a.kicad_sch]
2026-05-10 SIM: changed drive resistors to 10K, no change in behaviour
    10K should still provide plenty of current draw on the MOSFET gate.
    [basedonstackextl341.sch]
2026-05-10 SCH/PCB: 1% 5.6K resistor instead of 4.7K (1%) + 1K (5%)
    Technically this would have worked as-is, since the 5% for the 1K results in
    only a small change to the total resistance. The resulting voltage would be
    (according to SPICE) between 5.3V and 5.49V, compared to 5.3V and 5.41V.
    On the other hand I would expect a 1% resistor to also have a better tolerance
    to temperature changes, which I did not simulate with actual resistor models.
    The TL432 requires precise resistors if I want this OVP to work reliably.
    [bios-programmer-ch341a.kicad_pcb, bios-programmer-ch341a.kicad_sch]
2026-05-10 PCB: moving stuff; more GND; pcb all is well; before I increase clearance TODO
    [bios-programmer-ch341a.kicad_pcb]
2026-05-10 PCB increase clearances, no need to be tight; increased track widths; nets for all non-default?
    [bios-programmer-ch341a.kicad_pcb, bios-programmer-ch341a.kicad_sch]
2026-05-10 SCH/PCB: adding sense wires & some beautification
    Rationale: sense wires are not strictly necessary and the design would work
    perfectly without. It does however add some indication of the voltage as it is
    present on the IC under program through the IDC connectors. It is after all an
    unknown how long and thick the wires leading up to this IC are.
    That said, it wouldn't provide any insight in any voltage drop on the actual
    data lines and as such provide less information than really required.
    The routing, with one sense pair on the bottom and one on top is a result of
    requiring the same pinout on both IDC connectors. It is reasonable to expect
    that the IDC to clip 'adapter' can be used on both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
    [bios-programmer-ch341a.kicad_pcb, bios-programmer-ch341a.kicad_sch]
2026-05-10 PCB: additional LED resistor
    Previously having 2 resistors in parallel, leading to 2 parallel LEDs could
    potentially lead to an issue in case any of the LEDs fails or burns out. The
    other remaining LED would then have to bear all of the current and surely burn
    out as well.
    Note that the LEDs are already potentially overdriven, depening on the input
    voltage. That said, no more than 8V is supported for the power protection path
    anyway.
    [bios-programmer-ch341a.kicad_pcb, bios-programmer-ch341a.kicad_sch]
2026-05-10 pcb: silkscreens; 50x40 mil text 8mil (auto) thickness
    [bios-programmer-ch341a.kicad_pcb]
2026-05-10 PCB: silkscreen connector layouts
    [bios-programmer-ch341a.kicad_pcb]
2026-05-10 silkscreen table + some improvements
    [bios-programmer-ch341a.kicad_pcb]
2026-05-10 pcb silkscreen reference font Inconsolata
    [bios-programmer-ch341a.kicad_pcb]
2026-05-10 pcb silkscreen Anonymous Pro text disregard kicad check for TT font width; kicd font is thinner and not detected
    [bios-programmer-ch341a.kicad_pcb]
2026-05-10 PCB: silkscreen in metric & font taller than wide
    I think it looks kinda good with a much taller than wide font.
    Text boxes were replaced with text components which are much easier to position
    as intented. It is still difficult to get good text positioning/sizing in Kicad
    and having separate components works around this.
    [bios-programmer-ch341a.kicad_pcb]
2026-05-10 silkscreen table
    [bios-programmer-ch341a.kicad_pcb]
2026-05-10 pcb kicad font for value of leds
    [bios-programmer-ch341a.kicad_pcb]
2026-05-10 SCH/PCB: set C5 to DNP, not in the datasheet
    A 100nF capacitor is not in datasheet, but really the reason I removed it is
    because it's hard to place without reducing the GND zone to a thin track.
    [bios-programmer-ch341a.kicad_sch]
2026-05-10 PCB: changed overvoltage alert indicator to magic smoke alert
    It's not a commercial product anyway, warning for magic smoke is funnier than
    warning about an overvoltage alert.
    [bios-programmer-ch341a.kicad_pcb]
2026-05-10 pcb zone refill & silkscreen isolation zone
    [bios-programmer-ch341a.kicad_pcb]
2026-05-10 pcb vias & slikscreen fixes sda/scl
    [bios-programmer-ch341a.kicad_pcb]
2026-05-10 PCB led trace over back, bigger ground on front; bigger contig. zones; less cutting + text issue 6 Âum moved
    [bios-programmer-ch341a.kicad_pcb]
2026-05-10 PCB: embedded font "Anonymous Pro", used for the silkscreen (except references)
    Embedding fonts seems like a good idea, since there's no knowing if everyone
    who could potentially ever open this project have this font.
    [bios-programmer-ch341a.kicad_pcb]
2026-05-10 PCB: additional GND zone
    Small zone to improve the looks of that GND connection.
    [bios-programmer-ch341a.kicad_pcb]
2026-05-10 PCB: embedded font "Inconsolata", used for reference designators
    I used this font for my reference designators, very interested to see how it'll
    turn out at the different fabs I intend to use.
    I had to use a trick for Kicad to embed this one: add it in a copper "text"
    component which I then deleted. If it's only used in the reference designators
    it apparently doesn't get detected.
    [bios-programmer-ch341a.kicad_pcb]
2026-05-10 PCB/SCH: separate field Label for PCB label & sort manufacturer/part #s
    Using "Value" for the PCB label isn't terrible, but at the same time it's not
    really "locked down" as a separate label. There's no reason Value can't be used
    for something to indicate a certain message to the user in the schematics.
    It's also not clear for anyone looking at the schematics that that specific
    text is used on the PCB.
    Splitting up removes any ambiguity.
    [bios-programmer-ch341a.kicad_pcb, bios-programmer-ch341a.kicad_sch]
2026-05-10 PCB: silkscreen table text aligned to the middle & invert/knockout for signals
    Using ~ to indicate inverted signals is adequate, but literally using inverted
    silkscreen also indicates inversion well :)
    Vias were also moved to be out of the way of the silkscreen as much as possible.
    [bios-programmer-ch341a.kicad_pcb]
2026-05-10 SCH: added some part numbers
    Some part numbers have many possibilities, like 5% resistors. I assign these
    simply based on what I have in stock, sometimes using a more expensive one that
    uses up some of my (already very small) stock.
    [bios-programmer-ch341a.kicad_sch]
2026-05-10 3D: TODO message
    updated sense wire connector models, added U3 (ADum) caps & more part#s
    Previously I used a model which sort-of fit but already included in Kicad, now
    I use an actual model of what I can expect it to look like.
    The capacitors on the I2C isolator were in the datasheet, but it seems I forgot
    to duplicate them. I had somehow put the 100nF & 1nF on a different side of the
    isolation barrier. According to the datasheet I should have both on each side.
    Also some beautification of tracks.
    [397730002.stp, c-282834-2-c-3d.stp]
2026-05-10 PCB: updated sense wire connector models, added U3 (ADum) caps & more part#s
    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
    [bios-programmer-ch341a.kicad_pcb, bios-programmer-ch341a.kicad_sch]
2026-05-10 PCB: reset text "above" button
    "Above" because in reality the board is really upside down, but I don't want
    to turn the board and then have all other commits have the board upside down.
    That said, there is no definite up or down to the board, it's just that the
    banana jacks would most logically never be oriented towards the person using
    the programmer.
    [bios-programmer-ch341a.kicad_pcb]
2026-05-10 PCB: added manufacturer variable
    Even though I'm planning to have 3 manufacturers produce the same board, each
    in a different color, it's still useful to indicate which manufacturer did a
    particular board.
    [bios-programmer-ch341a.kicad_pcb]
2026-05-10 PCB: added copyright/personals & git
    [bios-programmer-ch341a.kicad_pcb]
2026-05-10 PCB: silkscreen for CS should also be inverted
    Apparently CS (chip select) for the SPI chips is also an inverted signal. It
    doesn't matter electrically (since it's coming straight out of the CH341 IC)
    but it's nice to keep the silkscreen correct.
    [bios-programmer-ch341a.kicad_pcb]
2026-05-10 PCB: rerouted SCL for more clearance; fixed reference J9 silkscreen
    It's strictly not necessary, but not going in-between the two connector pins
    adds some clearance. It won't hurt in any way.
    [bios-programmer-ch341a.kicad_pcb]
2026-05-10 SCH/PCB: pull-up & current-limiting resistors on signal lines where needed
    I don't know if this is useful let alone beneficial.
    The pull-up resistors on SPI & I2C signals should theoretically improve the
    current that is delivered out through the IDC connectors, right?
    The current-limiting resistors may or may not be a good thing. WP and RST on
    the SPI IDC connector were directly connected to VDD (the external lab power
    supplies' output). In theory other ICs connected to these lines could poten-
    tially be powered through them. Of course, it may reduce the current required
    on these pins below the HIGH signal. If it's an issue I can always replace
    these with 0-Ohm jumper resistors.
    Routing is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
    [bios-programmer-ch341a.kicad_pcb, bios-programmer-ch341a.kicad_sch]
2026-05-10 PCB: routing/beautification of tracks
    Yup, this time I used arcs to get around the through-hole footprint of the IDC
    connector J7 (SPI) on the bottom layer. It's actually faster and makes it so
    much nicer to look at. No more crooked tracks (there).
    [bios-programmer-ch341a.kicad_pcb]
2026-05-10 3D: ZIF socket coloured into more or less actual colors (TODO: better color match?)
    I can get the ZIF sockets in two colors: a cyan-like color and in black. The
    former I can procure on AliExpress (yes...) directly. The latter one is a bit
    harder: I can procure CH341 programmers which (hopefully) have a black ZIF
    socket. I can then desolder these. The cost is pretty much the same if I factor
    in the cost for the CH341 chip, which I'll also have to desolder.
    CH341A/B on LCSC (or AliExpress) is at least 1.2E each, the cost for a CH341
    programmer is that + the raw cost of a (cyan) ZIF socket.
    It checks out, with some extra steps.
    [3m_zif_dip16_socket_216-3340-00-0602J_black.stp, 3m_zif_dip16_socket_216-3340-00-0602J_cyan.stp]
2026-05-10 FOOTPRINT: ZIF socket, use cyan-color by default
    The cyan one is the only I can buy separately, so it makes sense to use this
    model color for what I basically release into the world.
2026-05-10 3D: replaced the USB model by Digikey-downloaded model
    The model I downloaded from the Amphenol website doesn't have any colour info
    in it, which for some strange reason ends up in a very annoying cyan-like shade.
    The digikey model has normal colouring information and thus looks nicer.
    [amphenol_micro_usb_10118194-0011lf.step, amphenol_micro_usb_11018193_2lf.stp]
2026-05-10 FOOTPRINT: Amphenol 10118194 flangeless Micro USB updated to latest model
2026-05-10 PCB: updated ZIF socket & Micro USB models to latest in footprints
    [bios-programmer-ch341a.kicad_pcb]
2026-05-10 PCB/SCH: updated part numbers & reset FAB layer fonts to Kicad default font
    There was no reason I wanted to change the fonts for any other than the silk-
    screen layers. No need to do this, it only complicates things.
    Part numbers were chosen to be as cheap as possible for small-scale production
    as I always do.
    [bios-programmer-ch341a.kicad_pcb, bios-programmer-ch341a.kicad_sch]
2026-05-10 TEMP footprint line test art
2026-05-10 TEMP inven
    [inventory.tsv]
2026-05-10 200 ohm current limiter resistor TODO calc
    [bios-programmer-ch341a.kicad_sch]
2026-05-10 pcb beautif? arcs?
    [bios-programmer-ch341a.kicad_pcb]
2026-05-10 3D: sense wire terminal block; requires reduced height (below 9mm!)
    [TBC05-02-1-G-G.stp]
2026-05-10 SCH/PCB: 200Ohm current limiting resistor part numbers updated
    [bios-programmer-ch341a.kicad_pcb, bios-programmer-ch341a.kicad_sch]
2026-05-10 permission statement ... TODO
    [bios-programmer-ch341a.kicad_pcb, bios-programmer-ch341a.kicad_sch]
