malavon/kicad-ch341-programmer/(notices)

Notices in the files:
3dmodels/TBC05-02-1-G-G.stp:
author */ ('License CC BY-ND 4.0'),
bios-programmer-ch341a.kicad_pcb:
©2026 Benny Goemans
